tembooo/Smart-platform/Pic12.jpg

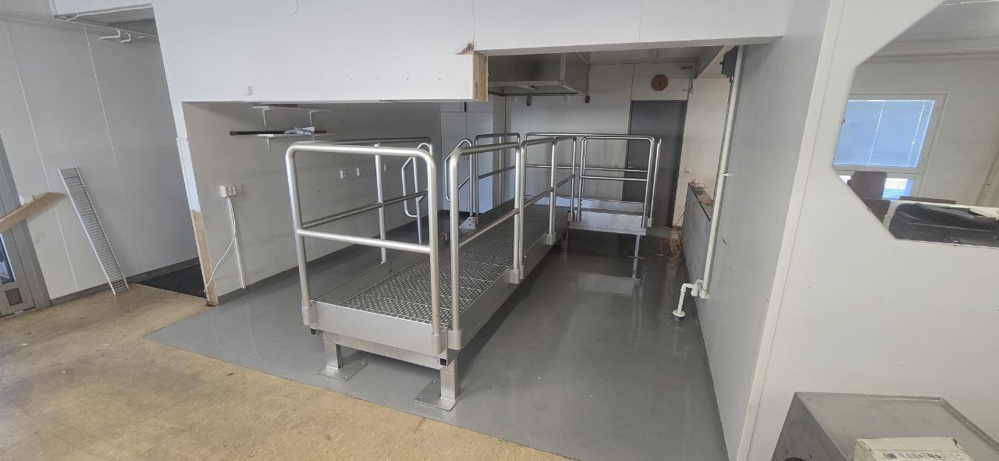
Pic12.jpg
