tembooo/Smart-platform/(list of files, cad)

Other CAD files:
Cad2.dwg
